mengstr/KimCard/doc/FrontR2.jpg

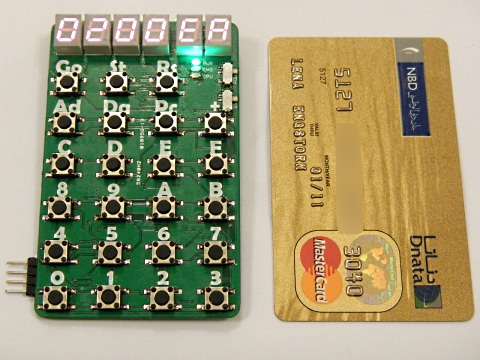
doc/FrontR2.jpg
