mengstr/KimCard/doc/Original_Kim-1.jpg

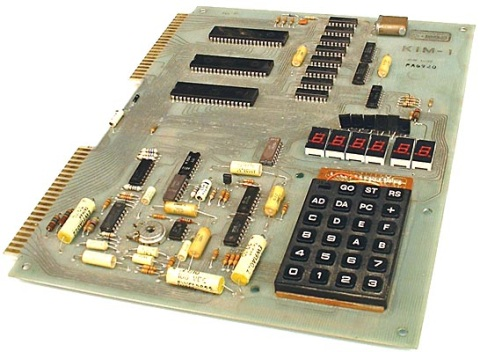
doc/Original_Kim-1.jpg
