mengstr/KimCard/doc/BackR2.jpg

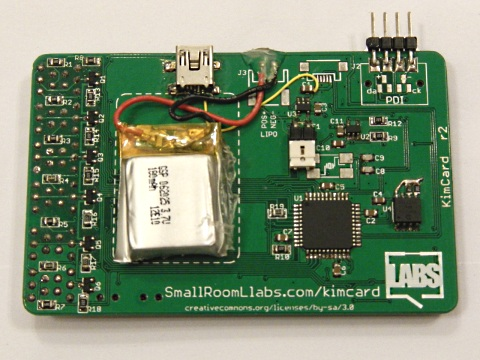
doc/BackR2.jpg
