mengstr/KimCard/doc/CheatSheet.bmp

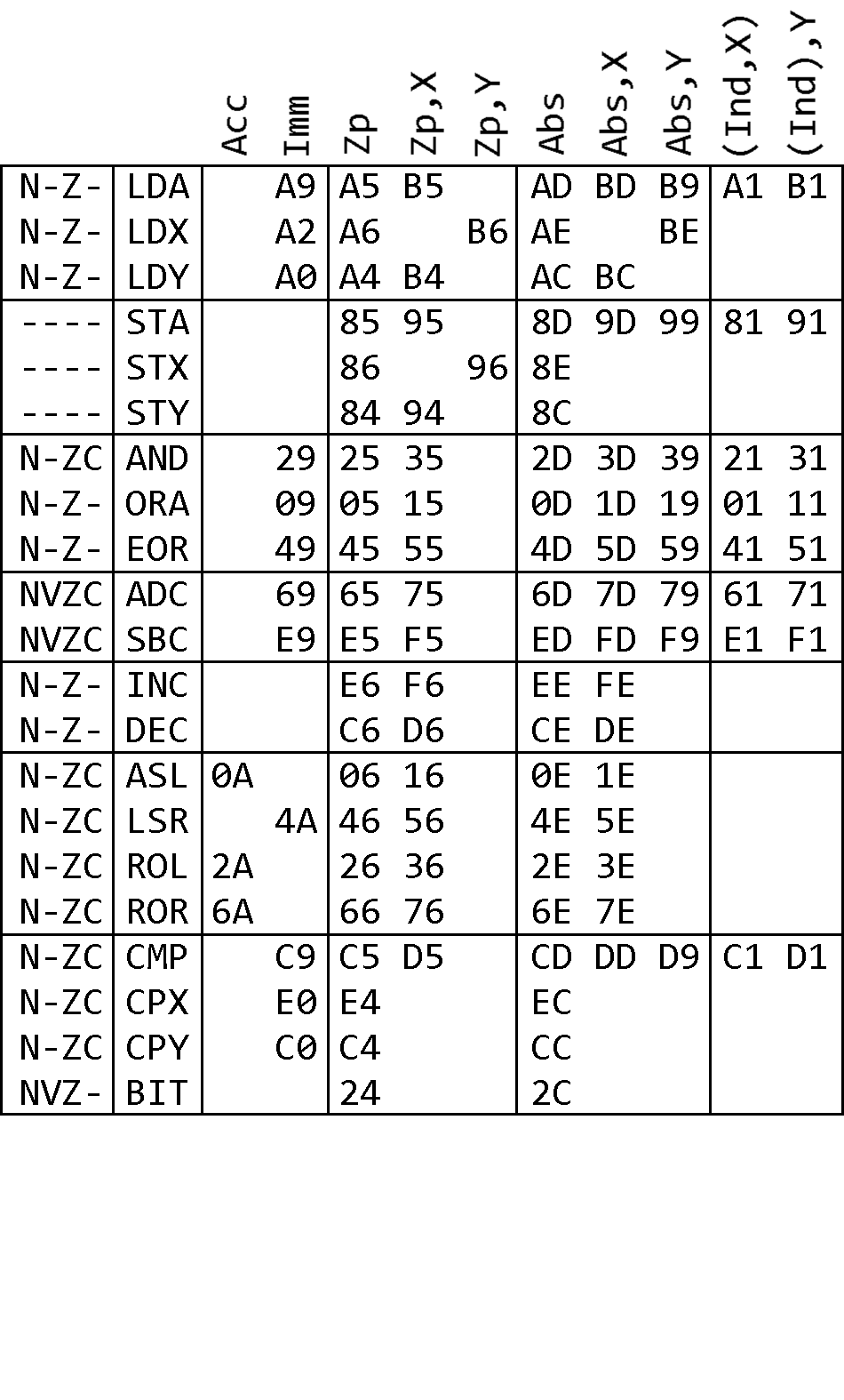
doc/CheatSheet.bmp
