mengstr/KimCard/doc/PCB Labels-r3.bmp

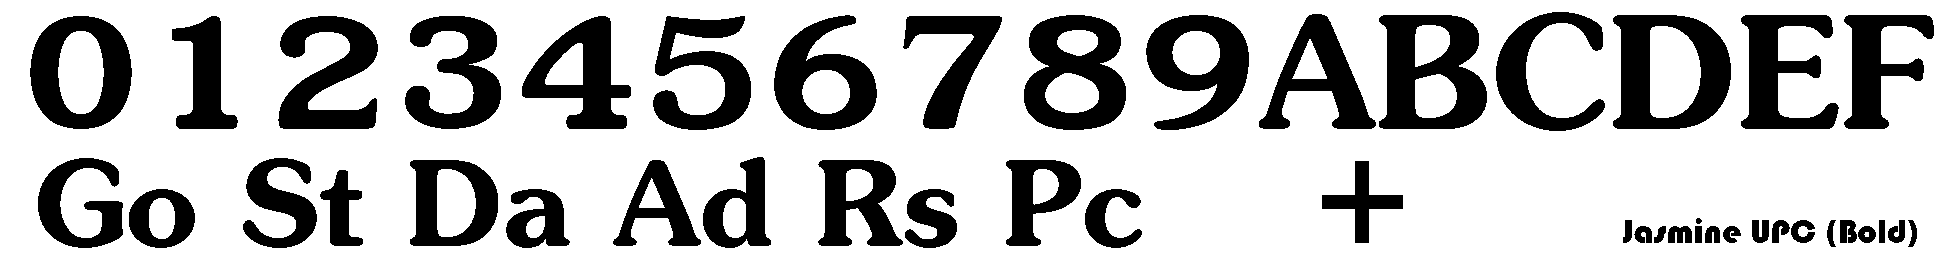
doc/PCB Labels-r3.bmp
