mengstr/KimCard/doc/PCB Labels.bmp

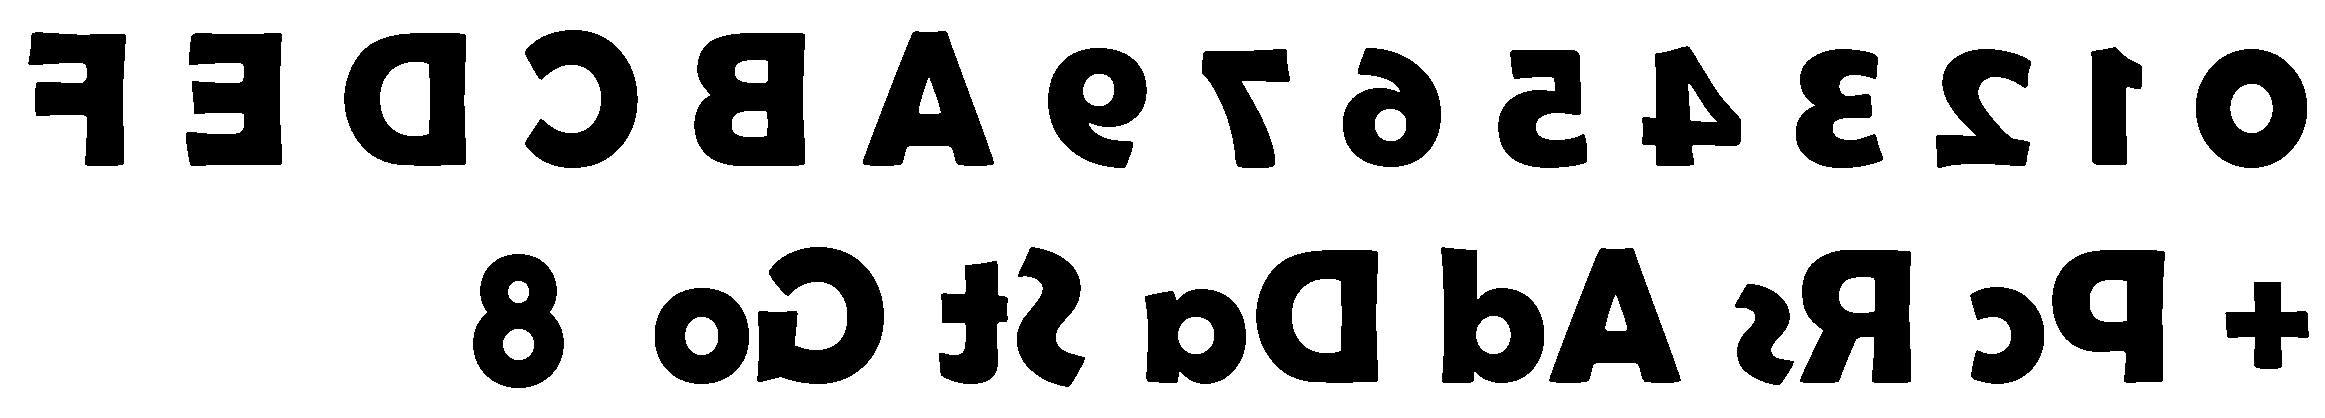
doc/PCB Labels.bmp
