mengstr/KimCard/pcb/KimCard-r5.brd

## EAGLE design pcb/KimCard-r5.brd (2015-05-03)

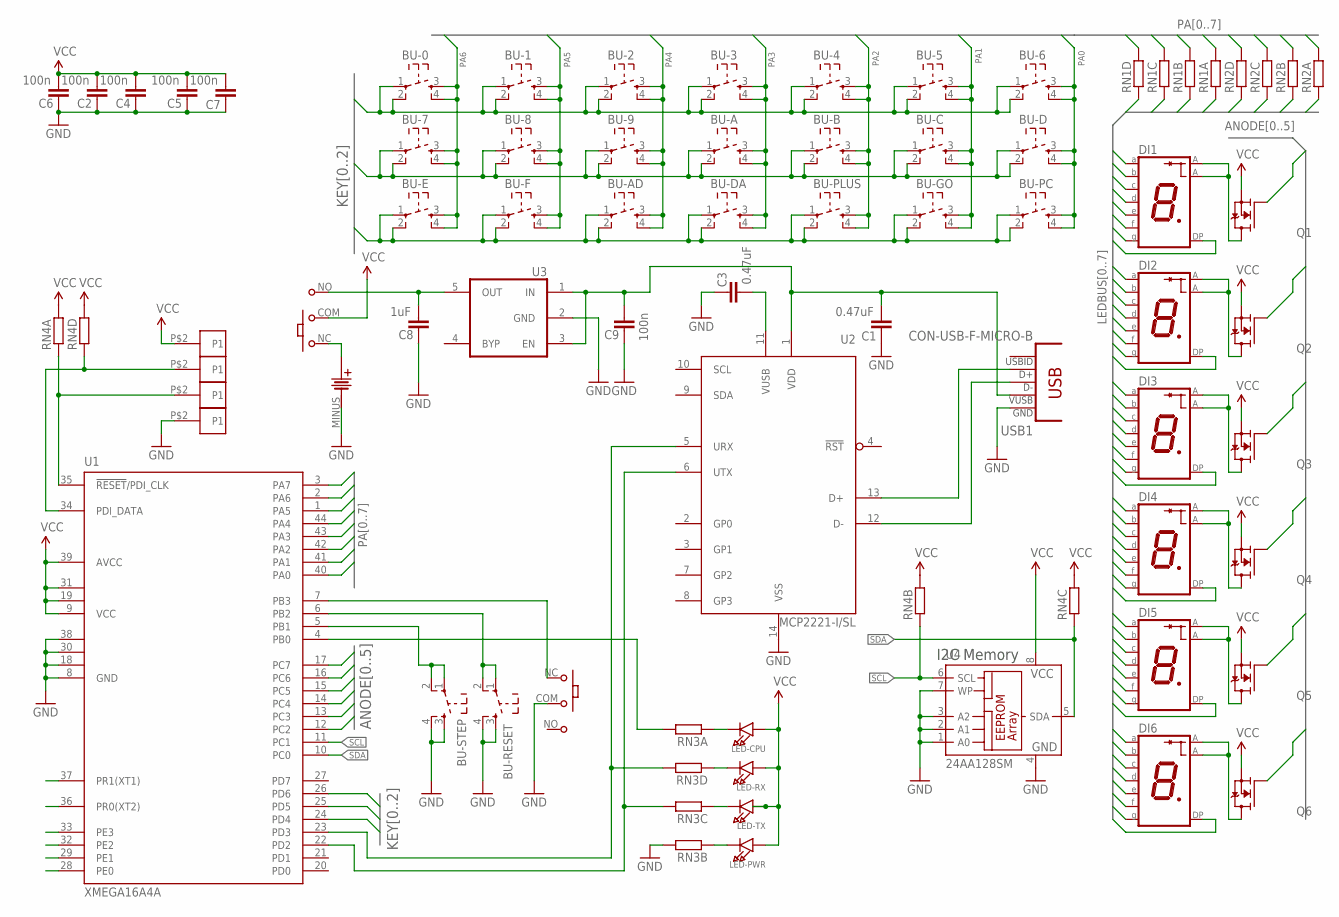
[picture p7: schematic KimCard-r5.sch]

Parts:
BA1: BATTERY-3V; AAAX2
BU-0, BU-1, BU-2, BU-3, BU-4, BU-5, BU-6, BU-7, BU-8, BU-9: SW_TACT_4P; SW_TACT_SMALL
BU-A: SW_TACT_4P; SW_TACT_SMALL
BU-AD: SW_TACT_4P; SW_TACT_SMALL
BU-B: SW_TACT_4P; SW_TACT_SMALL
BU-C: SW_TACT_4P; SW_TACT_SMALL
BU-D: SW_TACT_4P; SW_TACT_SMALL
BU-DA: SW_TACT_4P; SW_TACT_SMALL
BU-E: SW_TACT_4P; SW_TACT_SMALL
BU-F: SW_TACT_4P; SW_TACT_SMALL
BU-GO: SW_TACT_4P; SW_TACT_SMALL
BU-PC: SW_TACT_4P; SW_TACT_SMALL
BU-PLUS: SW_TACT_4P; SW_TACT_SMALL
BU-RESET: SW_TACT_4P; SW_TACT_SMALL
BU-STEP: SW_TACT_4P; SW_TACT_SMALL
C1, C3: 0.47uF; 0805
C2, C4, C5, C6, C7, C9: 100n; 0805
C8: 1uF; 0805
DI1, DI2, DI3, DI4, DI5, DI6: 7SEG-CA2; KCSA03
LED-CPU: LEDSMD0805; CHIPLED_0805
LED-PWR: LEDSMD0805; CHIPLED_0805
LED-RX: LEDSMD0805; CHIPLED_0805
LED-TX: LEDSMD0805; CHIPLED_0805
PDI-CLK: PAD-2X3; PAD2X3
PDI-DATA: PAD-2X3; PAD2X3
PDI-GND: PAD-2X3; PAD2X3
PDI-VCC: PAD-2X3; PAD2X3
Q1, Q2, Q3, Q4, Q5, Q6: TRANSISTOR_FET_BS170-SOT-23; SOT-23
RN1, RN2, RN3, RN4: RESISTOR_ARRAY_4; RN8P-4R-CRA06S
U1: XMEGA16A4A; TQFP44
U2: MCP2221-I/SL; SOIC14
U3: VREG_5PINS-SOT-23-5; SOT-23-5
U4: 24AA128SM; SO-08M
U$1, U$2: SLIDESWITCHPCM12SMTR; PCM12SMTR
USB1: CON-USB-F-MICRO-B; CONN_USB_MICRO-B

Connections:
BAT: BA1.PLUS, U$1.NC
CPU: RN3.8 (2), U1.4 (PB0)
GND: BA1.MINUS, BU-RESET.3, BU-RESET.4, BU-STEP.3, BU-STEP.4, C1.1, C2.1, C3.1, C4.1, C5.1, C6.1, C7.1, C8.1, C9.1, PDI-GND.P$2, RN3.7 (2), U1.8 (GND), U1.18 (GND1), U1.30 (GND2), U1.38 (GND3), U2.14 (VSS), U3.2 (GND), U4.1 (A0), U4.2 (A1), U4.3 (A2), U4.4 (GND), U4.7 (WP), U$2.COM, USB1.P5 (GND)
KEYROW0: BU-0.1, BU-0.2, BU-1.1, BU-1.2, BU-2.1, BU-2.2, BU-3.1, BU-3.2, BU-4.1, BU-4.2, BU-5.1, BU-5.2, BU-6.1, BU-6.2, U1.24 (PD4)
KEYROW1: BU-7.1, BU-7.2, BU-8.1, BU-8.2, BU-9.1, BU-9.2, BU-A.1, BU-A.2, BU-B.1, BU-B.2, BU-C.1, BU-C.2, BU-D.1, BU-D.2, U1.25 (PD5)
KEYROW2: BU-AD.1, BU-AD.2, BU-DA.1, BU-DA.2, BU-E.1, BU-E.2, BU-F.1, BU-F.2, BU-GO.1, BU-GO.2, BU-PC.1, BU-PC.2, BU-PLUS.1, BU-PLUS.2, U1.26 (PD6)
LEDBUS0: DI1.P$7 (A), DI2.P$7 (A), DI3.P$7 (A), DI4.P$7 (A), DI5.P$7 (A), DI6.P$7 (A), RN2.1
LEDBUS1: DI1.P$6 (B), DI2.P$6 (B), DI3.P$6 (B), DI4.P$6 (B), DI5.P$6 (B), DI6.P$6 (B), RN2.2 (1)
LEDBUS2: DI1.P$4 (C), DI2.P$4 (C), DI3.P$4 (C), DI4.P$4 (C), DI5.P$4 (C), DI6.P$4 (C), RN2.3 (1)
LEDBUS3: DI1.P$2 (D), DI2.P$2 (D), DI3.P$2 (D), DI4.P$2 (D), DI5.P$2 (D), DI6.P$2 (D), RN2.4 (1)
LEDBUS4: DI1.P$1 (E), DI2.P$1 (E), DI3.P$1 (E), DI4.P$1 (E), DI5.P$1 (E), DI6.P$1 (E), RN1.1
LEDBUS5: DI1.P$9 (F), DI2.P$9 (F), DI3.P$9 (F), DI4.P$9 (F), DI5.P$9 (F), DI6.P$9 (F), RN1.2 (1)
LEDBUS6: DI1.P$10 (G), DI2.P$10 (G), DI3.P$10 (G), DI4.P$10 (G), DI5.P$10 (G), DI6.P$10 (G), RN1.3 (1)
LEDBUS7: DI1.P$5 (DP), DI2.P$5 (DP), DI3.P$5 (DP), DI4.P$5 (DP), DI5.P$5 (DP), DI6.P$5 (DP), RN1.4 (1)
LEDCA0: Q1.1 (G), U1.12 (PC2)
LEDCA1: Q2.1 (G), U1.13 (PC3)
LEDCA2: Q3.1 (G), U1.14 (PC4)
LEDCA3: Q4.1 (G), U1.15 (PC5)
LEDCA4: Q5.1 (G), U1.16 (PC6)
LEDCA5: Q6.1 (G), U1.17 (PC7)
unnamed: RN3.5 (2), U1.23 (PD3), U2.5 (URX)
unnamed: LED-RX.C, RN3.4 (1)
unnamed: U2.13 (D+), USB1.P3 (D+)
unnamed: U2.12 (D-), USB1.P2 (D-)
unnamed: C3.2, U2.11 (VUSB)
unnamed: RN3.6 (2), U1.22 (PD2), U2.6 (UTX)
unnamed: LED-TX.C, RN3.3 (1)
unnamed: C8.2, U3.5 (OUT), U$1.NO
unnamed: LED-PWR.C, RN3.2 (1)
unnamed: LED-CPU.C, RN3.1
PA0: BU-6.3, BU-6.4, BU-D.3, BU-D.4, BU-PC.3, BU-PC.4, RN2.8 (2), U1.40 (PA0)
PA1: BU-5.3, BU-5.4, BU-C.3, BU-C.4, BU-GO.3, BU-GO.4, RN2.7 (2), U1.41 (PA1)
PA2: BU-4.3, BU-4.4, BU-B.3, BU-B.4, BU-PLUS.3, BU-PLUS.4, RN2.6 (2), U1.42 (PA2)
PA3: BU-3.3, BU-3.4, BU-A.3, BU-A.4, BU-DA.3, BU-DA.4, RN2.5 (2), U1.43 (PA3)
PA4: BU-2.3, BU-2.4, BU-9.3, BU-9.4, BU-AD.3, BU-AD.4, RN1.8 (2), U1.44 (PA4)
PA5: BU-1.3, BU-1.4, BU-8.3, BU-8.4, BU-F.3, BU-F.4, RN1.7 (2), U1.1 (PA5)
PA6: BU-0.3, BU-0.4, BU-7.3, BU-7.4, BU-E.3, BU-E.4, RN1.6 (2), U1.2 (PA6)
PA7: RN1.5 (2), U1.3 (PA7)
PDI_CLOCK: PDI-CLK.P$2, RN4.1, U1.35 (!RESET!/PDI_CLK)
PDI_DATA: PDI-DATA.P$2, RN4.4 (1), U1.34 (PDI_DATA)
PE0: U1.28 (PE0)
PE1: U1.29 (PE1)
PE2: U1.32 (PE2)
PE3: U1.33 (PE3)
PR1: U1.37 (PR1(XT1))
PR2: U1.36 (PR0(XT2))
Q1C: DI1.P$3 (A), DI1.P$8 (A), Q1.3 (D)
Q2C: DI2.P$3 (A), DI2.P$8 (A), Q2.3 (D)
Q3C: DI3.P$3 (A), DI3.P$8 (A), Q3.3 (D)
Q4C: DI4.P$3 (A), DI4.P$8 (A), Q4.3 (D)
Q5C: DI5.P$3 (A), DI5.P$8 (A), Q5.3 (D)
Q6C: DI6.P$3 (A), DI6.P$8 (A), Q6.3 (D)
RSET: BU-RESET.1, BU-RESET.2, U1.6 (PB2)
SCL: RN4.2 (1), U1.11 (PC1), U4.6 (SCL)
SDA: RN4.3 (1), U1.10 (PC0), U4.5 (SDA)
SST: U1.7 (PB3), U$2.NC
STEP: BU-STEP.1, BU-STEP.2, U1.5 (PB1)
VCC: C2.2, C4.2, C5.2, C6.2, C7.2, LED-CPU.A, LED-PWR.A, LED-RX.A, LED-TX.A, PDI-VCC.P$2, Q1.2 (S), Q2.2 (S), Q3.2 (S), Q4.2 (S), Q5.2 (S), Q6.2 (S), RN4.5 (2), RN4.6 (2), RN4.7 (2), RN4.8 (2), U1.9 (VCC), U1.19 (VCC1), U1.31 (VCC2), U1.39 (AVCC), U4.8 (VCC), U$1.COM
VUSB: C1.2, C9.2, U2.1 (VDD), U3.1 (IN), U3.3 (EN), USB1.P1 (VUSB)

Notes on the sheet:
I2C Memory

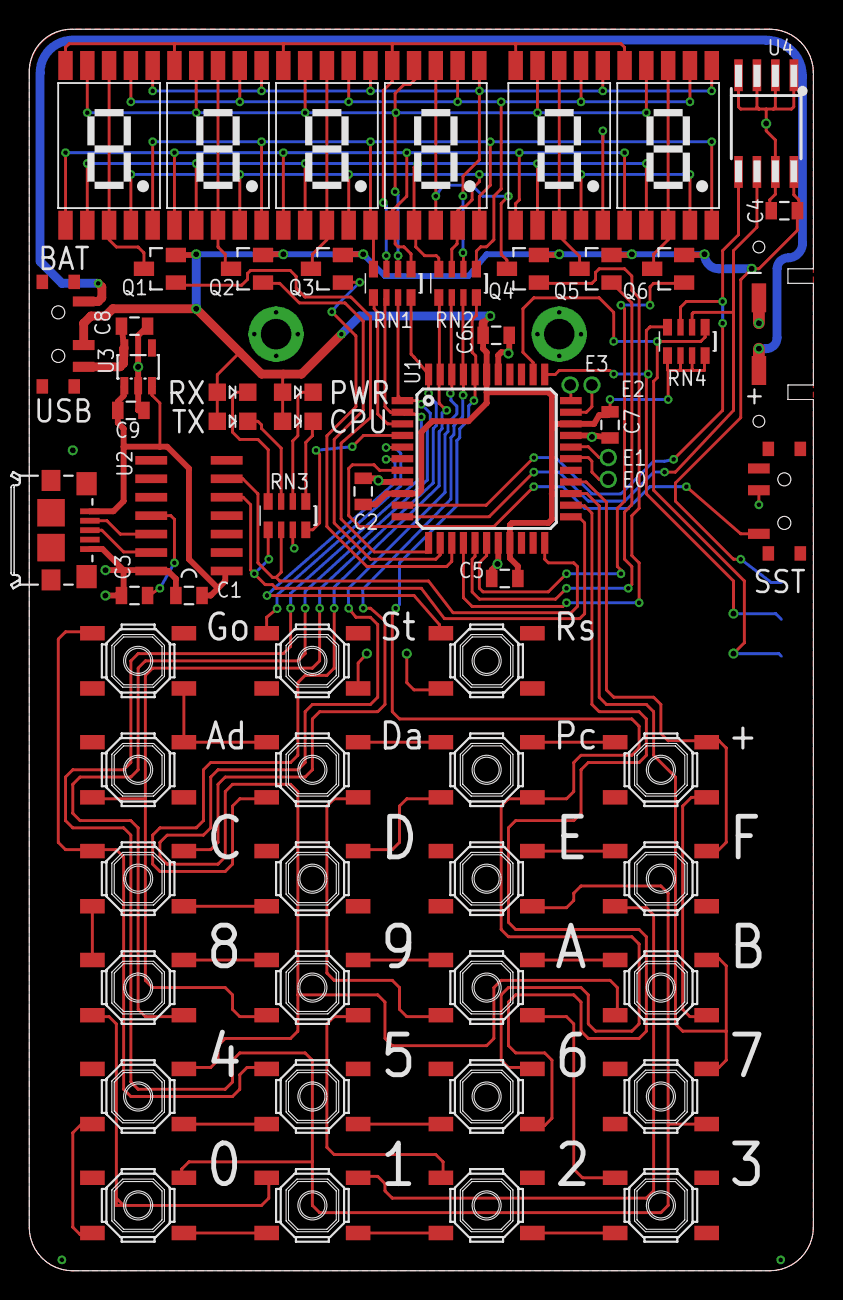
[picture p8: board KimCard-r5.brd from above]

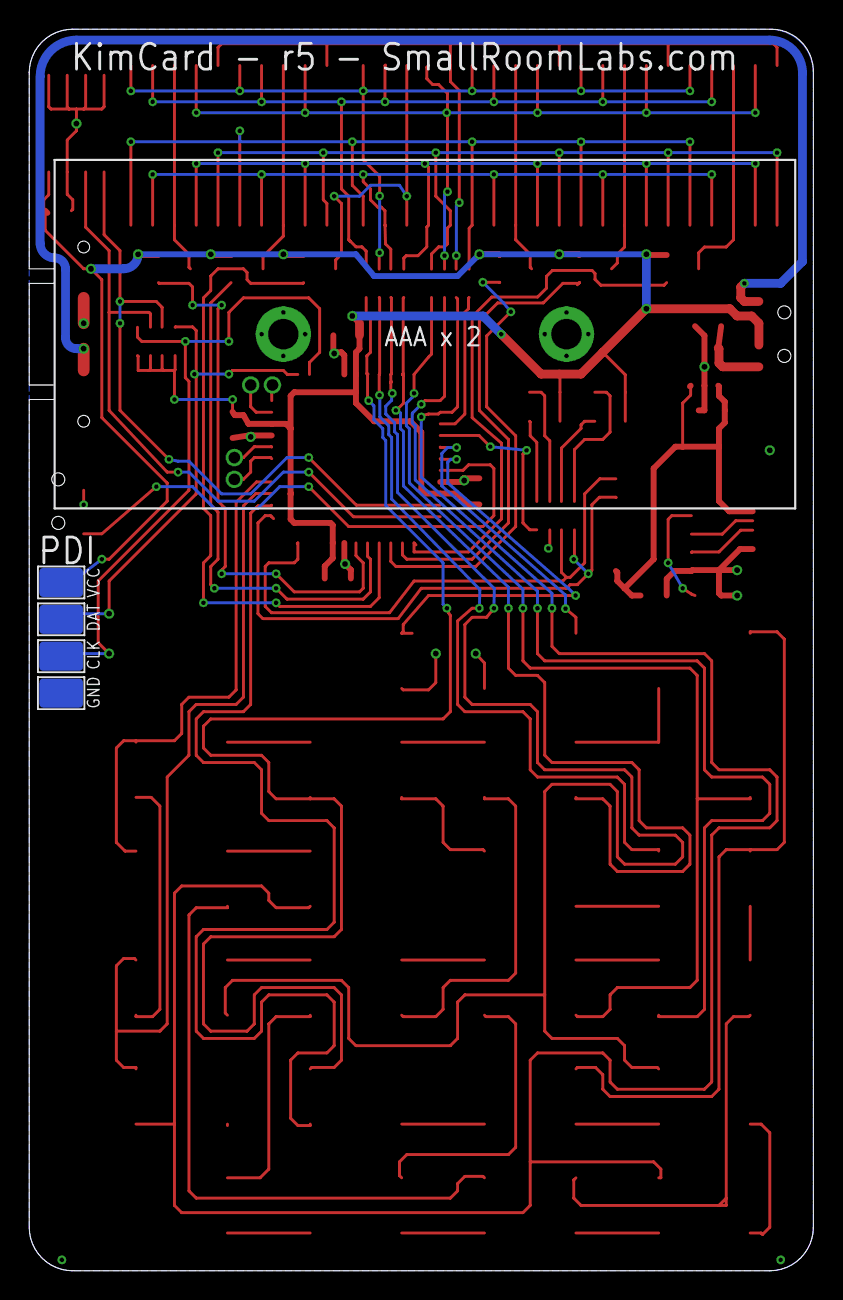
[picture p9: board KimCard-r5.brd from below]

Board: 2 copper layers, 54.0 x 85.5 mm, 65 parts (5 on the bottom side), 53 nets.

Other parts of the board:
U$7: SRL-LOGO-STOP-5MM
