mengstr/KimCard/code/KimCard/KimCard/kim1-bios.h

//
// START OF BIOS
//

uint8_t kim1_bios[1024] EEMEM = {
	0x85,0xF3,0x68,0x85,0xF1,0x68,0x85,0xEF,0x85,0xFA,0x68,0x85,0xF0,0x85,0xFB,0x84,
	0xF4,0x86,0xF5,0xBA,0x86,0xF2,0x20,0x88,0x1E,0x4C,0x4F,0x1C,0x6C,0xF6,0x00,0x6C,
	0xED,0x00,0xA2,0xFF,0x9A,0x86,0xF2,0x20,0x88,0x1E,0xEA,0xEA,0xEA,0xEA,0xEA,0xEA,
	0xEA,0xEA,0xEA,0xEA,0xEA,0xEA,0xEA,0xEA,0xEA,0xEA,0xEA,0xEA,0xEA,0xEA,0xEA,0xEA,
	0xEA,0xEA,0xEA,0xEA,0xEA,0xEA,0xEA,0xEA,0xEA,0xEA,0xEA,0xEA,0xEA,0xEA,0xEA,0x20,
	0x8C,0x1E,0x4C,0x78,0x1C,0xEA,0xEA,0xEA,0xEA,0xEA,0xEA,0xEA,0xEA,0xEA,0xEA,0xEA,
	0xEA,0xEA,0xEA,0xEA,0xEA,0xEA,0xEA,0xEA,0xEA,0xEA,0xEA,0xEA,0xEA,0xEA,0xEA,0xEA,
	0xEA,0xEA,0xEA,0xEA,0xEA,0xEA,0xEA,0xEA,0x20,0x19,0x1F,0xD0,0xD2,0xEA,0xEA,0xEA,
	0xEA,0xEA,0xEA,0x20,0x19,0x1F,0xF0,0xF5,0x20,0x19,0x1F,0xF0,0xF0,0x20,0x6A,0x1F,
	0xC9,0x15,0x10,0xBB,0xC9,0x14,0xF0,0x44,0xC9,0x10,0xF0,0x2C,0xC9,0x11,0xF0,0x2C,
	0xC9,0x12,0xF0,0x2F,0xC9,0x13,0xF0,0x31,0x0A,0x0A,0x0A,0x0A,0x85,0xFC,0xA2,0x04,
	0xA4,0xFF,0xD0,0x0A,0xB1,0xFA,0x06,0xFC,0x2A,0x91,0xFA,0x4C,0xC3,0x1C,0x0A,0x26,
	0xFA,0x26,0xFB,0xCA,0xD0,0xEA,0xF0,0x08,0xA9,0x01,0xD0,0x02,0xA9,0x00,0x85,0xFF,
	0x4C,0x4F,0x1C,0x20,0x63,0x1F,0x4C,0x4F,0x1C,0x4C,0xC8,0x1D,0xA5,0xEF,0x85,0xFA,
	0xA5,0xF0,0x85,0xFB,0x4C,0x4F,0x1C,0xEA,0xEA,0xEA,0xEA,0xEA,0xEA,0xEA,0xEA,0xEA,
	0xEA,0xEA,0xEA,0xEA,0xEA,0xEA,0xEA,0xEA,0xEA,0xEA,0xEA,0xEA,0xEA,0xEA,0xEA,0xEA,
	0xEA,0xEA,0xEA,0xEA,0xEA,0xEA,0xEA,0xEA,0xEA,0xEA,0xEA,0xEA,0xEA,0xEA,0xEA,0xEA,
	0xEA,0xEA,0xEA,0xEA,0xEA,0xEA,0xEA,0xEA,0xEA,0xEA,0xEA,0xEA,0xEA,0xEA,0xEA,0xEA,
	0xEA,0xEA,0xEA,0xEA,0xEA,0xEA,0xEA,0xEA,0xEA,0xEA,0xEA,0xEA,0xEA,0xEA,0xEA,0xEA,
	0xEA,0xEA,0xEA,0xEA,0xEA,0xEA,0xEA,0xEA,0xEA,0xEA,0xEA,0xEA,0xEA,0xEA,0xEA,0xEA,
	0xEA,0xEA,0xEA,0xEA,0xEA,0xEA,0xEA,0xEA,0xEA,0xEA,0xEA,0xEA,0xEA,0xEA,0xEA,0xEA,
	0xEA,0xEA,0xEA,0xEA,0xEA,0xEA,0xEA,0xEA,0xEA,0xEA,0xEA,0xEA,0xEA,0xEA,0xEA,0xEA,
	0xEA,0xEA,0xEA,0xEA,0xEA,0xEA,0xEA,0xEA,0xEA,0xEA,0xEA,0xEA,0xEA,0xEA,0xEA,0xEA,
	0xEA,0xEA,0xEA,0xEA,0xEA,0xEA,0xEA,0xEA,0xEA,0xEA,0xEA,0xEA,0xEA,0xEA,0xEA,0xEA,
	0xEA,0xEA,0xEA,0xEA,0xEA,0xEA,0xEA,0xEA,0xEA,0xEA,0xEA,0xEA,0xEA,0xEA,0xEA,0xEA,
	0xEA,0xEA,0xEA,0xEA,0xEA,0xEA,0xEA,0xEA,0xEA,0xEA,0xEA,0xEA,0xEA,0xEA,0xEA,0xEA,
	0xEA,0xEA,0xEA,0xEA,0xEA,0xEA,0xEA,0xEA,0xEA,0xEA,0xEA,0xEA,0xEA,0xEA,0xEA,0xEA,
	0xEA,0xEA,0xEA,0xEA,0xEA,0xEA,0xEA,0xEA,0xEA,0xEA,0xEA,0xEA,0xEA,0xEA,0xEA,0xEA,
	0xEA,0xEA,0xEA,0xEA,0xEA,0xEA,0xEA,0x00,0xA6,0xF2,0x9A,0xA5,0xFB,0x48,0xA5,0xFA,
	0x48,0xA5,0xF1,0x48,0xA6,0xF5,0xA4,0xF4,0xA5,0xF3,0x40,0xEA,0xEA,0xEA,0xEA,0xEA,
	0xEA,0xEA,0xEA,0xEA,0xEA,0xEA,0xEA,0xEA,0xEA,0xEA,0xEA,0xEA,0xEA,0xEA,0xEA,0xEA,
	0xEA,0xEA,0xEA,0xEA,0xEA,0xEA,0xEA,0xEA,0xEA,0xEA,0xEA,0xEA,0xEA,0xEA,0xEA,0xEA,
	0xEA,0xEA,0xEA,0xEA,0xEA,0xEA,0xEA,0xEA,0xEA,0xEA,0xEA,0xEA,0xEA,0xEA,0xEA,0xEA,
	0xEA,0xEA,0xEA,0xEA,0xEA,0xEA,0xEA,0xEA,0xEA,0xEA,0xEA,0xEA,0xEA,0xEA,0xEA,0xEA,
	0xEA,0xEA,0xEA,0xEA,0xEA,0xEA,0xEA,0xEA,0xEA,0xEA,0xEA,0xEA,0xEA,0xEA,0xEA,0xEA,
	0xEA,0xEA,0xEA,0xEA,0xEA,0xEA,0xEA,0xEA,0xEA,0xEA,0xEA,0xEA,0xEA,0xEA,0xEA,0xEA,
	0xEA,0xEA,0xEA,0xEA,0xEA,0xEA,0xEA,0xEA,0xEA,0xEA,0xEA,0xEA,0xEA,0xEA,0xEA,0xEA,
	0xEA,0xEA,0xEA,0xEA,0xEA,0xEA,0xEA,0xEA,0xEA,0xEA,0xEA,0xEA,0xEA,0xEA,0xEA,0xEA,
	0xEA,0xEA,0xEA,0xEA,0xEA,0xEA,0xEA,0xEA,0xEA,0xEA,0xEA,0xEA,0xEA,0xEA,0xEA,0xEA,
	0xEA,0xEA,0xEA,0xEA,0xEA,0xEA,0xEA,0xEA,0xEA,0xEA,0xEA,0xEA,0xEA,0xEA,0xEA,0xEA,
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
};


//
// END OF BIOS
// 
