mengstr/KimCard/(commit log)

2011-03-01 Eagle PCB files added
    [KimCard.brd, KimCard.sch]
2011-03-02 Opcode fetch fixed to use correct SRAM page
    [kimcard.asm]
2011-03-06 Added 6502.exe assembler/simulator
2011-03-06 Page fixing code as a macro
    [kimcard.asm]
2012-06-27 Renamed orginal Mega644 PCB to v1
    [KimCard-v1.brd, KimCard-v1.sch]
2012-06-27 Routed XMEGA version of the board
    [KimCard-v2.brd, KimCard-v2.sch]
2012-06-28 Minor touchups on layout
    [KimCard-v2.brd, KimCard-v2.sch]
2012-10-25 Final version of V2 board & Gerbers
    [KimCard-v2.GBL, KimCard-v2.GBO, KimCard-v2.GBP, KimCard-v2.GBS, KimCard-v2.GTL, KimCard-v2.GTO, KimCard-v2.GTP, KimCard-v2.GTS]
2012-10-25 Added MOS logo for pcb backside
2012-10-25 Cleaned up deleted files
    [KimCard.brd, KimCard.sch]
2012-10-25 Routing incomplete. Changed to SMD displays. Fixed button swaps.
    [KimCard-r3.brd, KimCard-r3.sch]
2012-10-26 More routing. Added FT201 as USB option.
    [KimCard-r3.brd, KimCard-r3.sch]
2012-10-26 More routing.
    [KimCard-r3.brd, KimCard-r3.sch]
2012-10-27 Everything routed
    [KimCard-r3.brd]
2012-10-27 Files for 6502 Cheat Sheet
    [6502CheatSheet.brd]
2012-10-27 Fixed part labels
    [KimCard-r3.brd, KimCard-r3.sch]
2012-10-27 Final routing & fixes for GND/VCC
    [KimCard-r3.brd, KimCard-r3.sch]
2012-10-28 Fixed CMP emulation by inverting Carry after the CP-instruction
    [main.c]
2015-05-01 All parts on top
    [KimCard-r5.brd, KimCard-r5.sch]
2015-05-03 Rev 5 almost finalized. Needs silk tuneups
    [KimCard-r5.brd, KimCard-r5.sch]
