mengstr/KimCard/(notices)

Notices in the files:
parts and their libraries:
SmallRoomLabs: Copyright(c) 2011 Mats Engstrom - mats@smallroomlabs.com
SmallRoomLabs: http://creativecommons.org/licenses/by-sa/3.0
SmallRoomLabs: STANDARD FRAME w. Copyright & License info
